Hi-iamAT/IOT_ESP32_Smart_Waste_Sorter/Project_images/wiring.jpeg

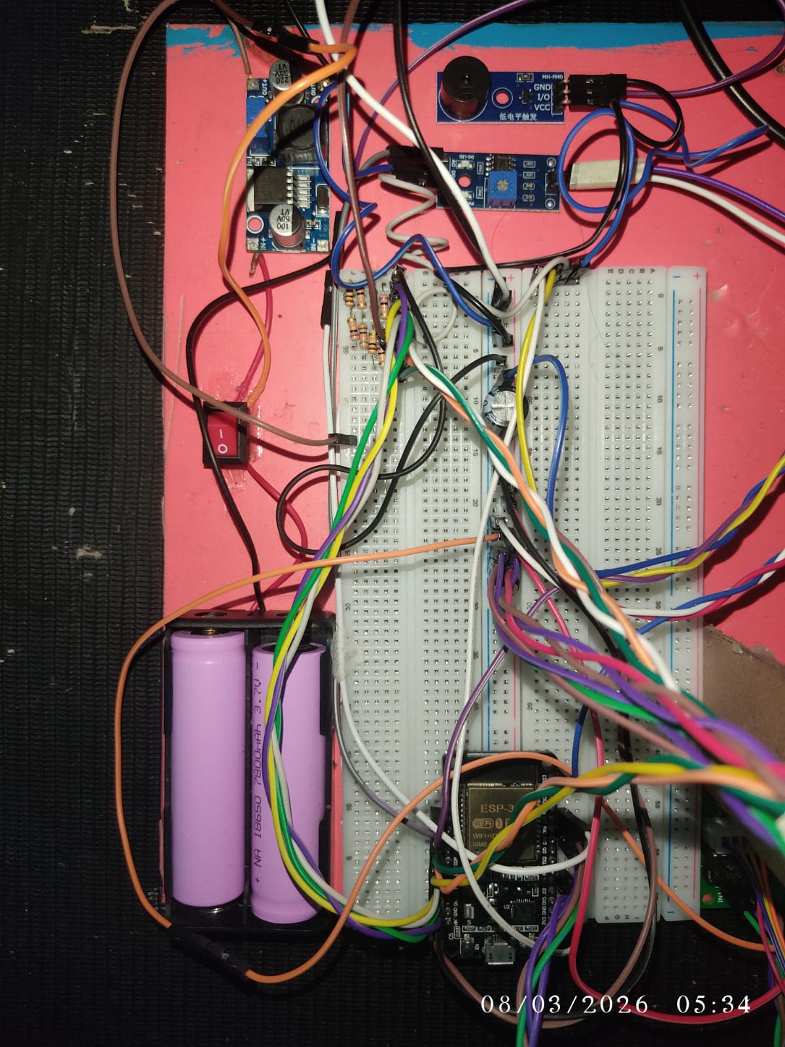
Project_images/wiring.jpeg
