Hi-iamAT/IOT_ESP32_Smart_Waste_Sorter/Project_images/full_view.jpeg

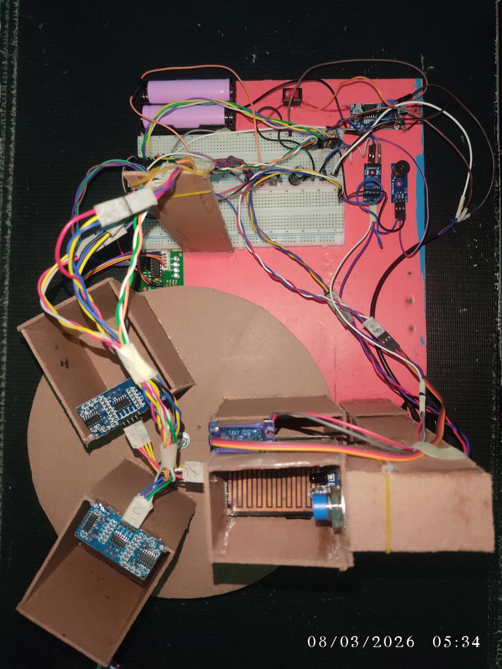
Project_images/full_view.jpeg
