Hi-iamAT/IOT_ESP32_Smart_Waste_Sorter/Project_images/3_bins.jpeg

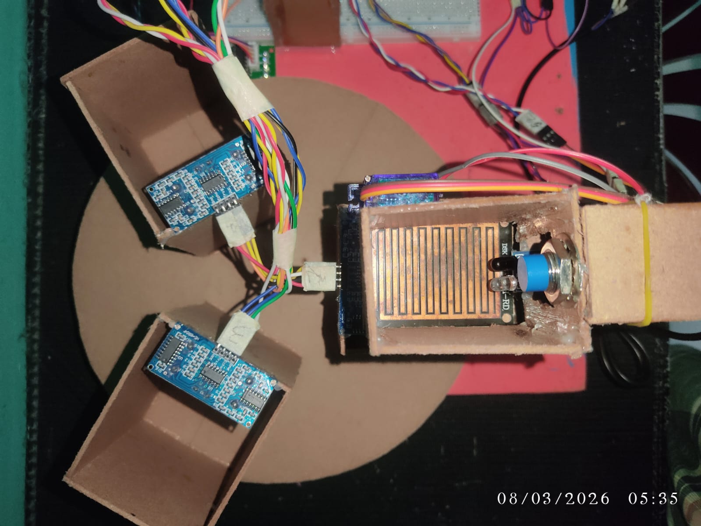
Project_images/3_bins.jpeg
