Hi-iamAT/IOT_ESP32_Smart_Waste_Sorter/Project_images/bin.jpeg

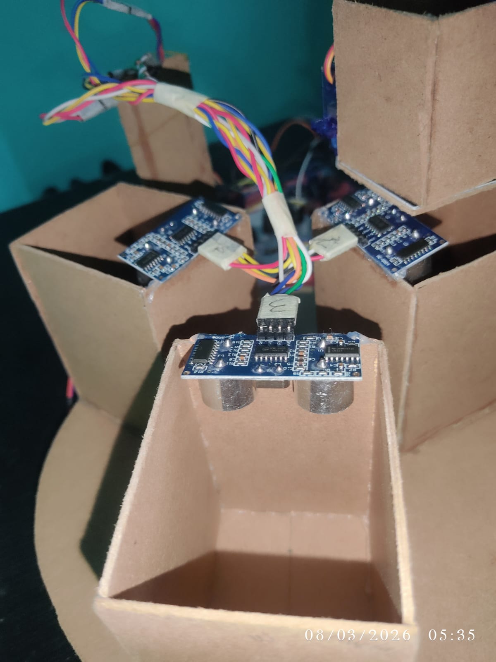
Project_images/bin.jpeg
