Hi-iamAT/IOT_ESP32_Smart_Waste_Sorter/Project_images/stepper_motor.jpeg

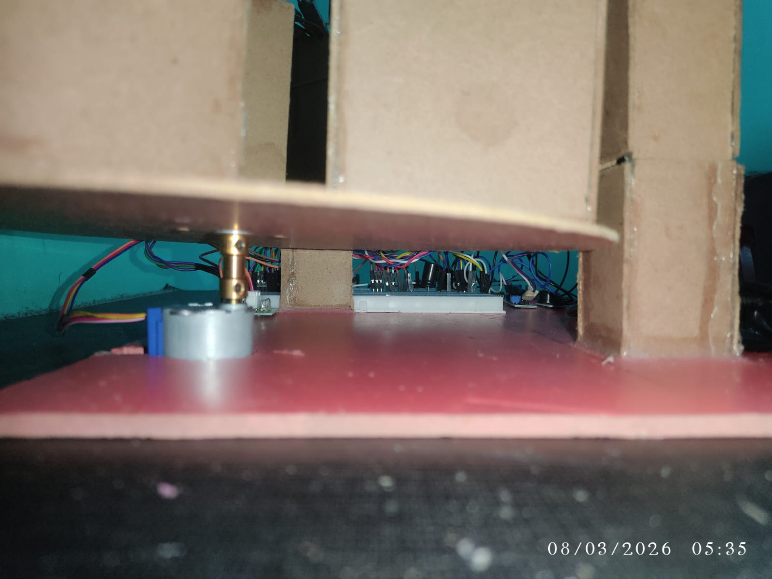
Project_images/stepper_motor.jpeg
