Hi-iamAT/IOT_ESP32_Smart_Waste_Sorter/(commit log)

2026-03-07 Initial commit: ESP32 Smart Waste Sorter
2026-03-07 Add full wiring guide with circuit diagram
2026-03-08 Final README update - thumbnails, dashboard, wiring link
2026-03-27 Update link to full wiring instructions in README
