Hi-iamAT/IOT_ESP32_Smart_Waste_Sorter/(notices)

Notices in the files:
README.md:
License: MIT
